dj140/FurutaPendulum_PJT/README.md

# FurutaPendulum_PJT

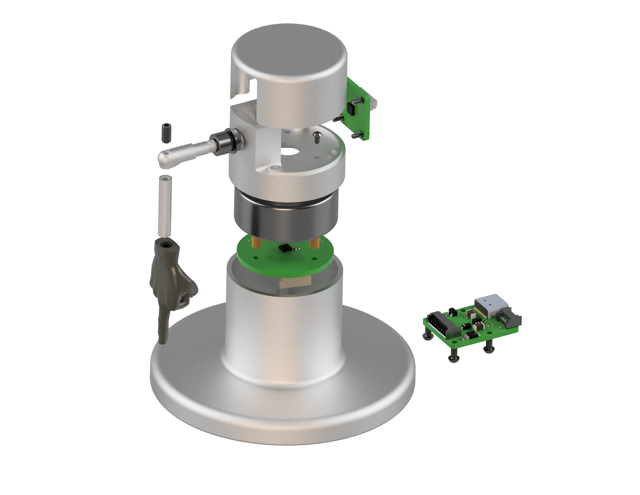
[picture p1: IMG/image2.png]


https://user-images.githubusercontent.com/33819388/154991899-b6fe6e4b-3fc9-4029-be56-d972ed57666c.mp4
