dj140/FurutaPendulum_PJT/IMG/image1.png

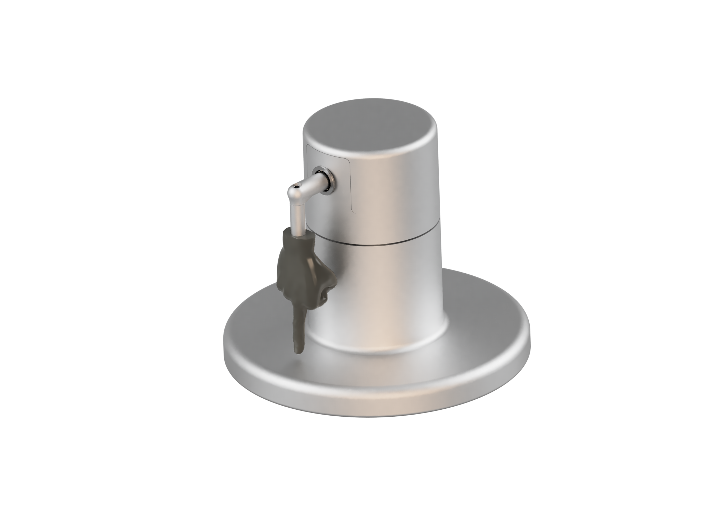
IMG/image1.png
