dj140/FurutaPendulum_PJT/IMG/image3.png

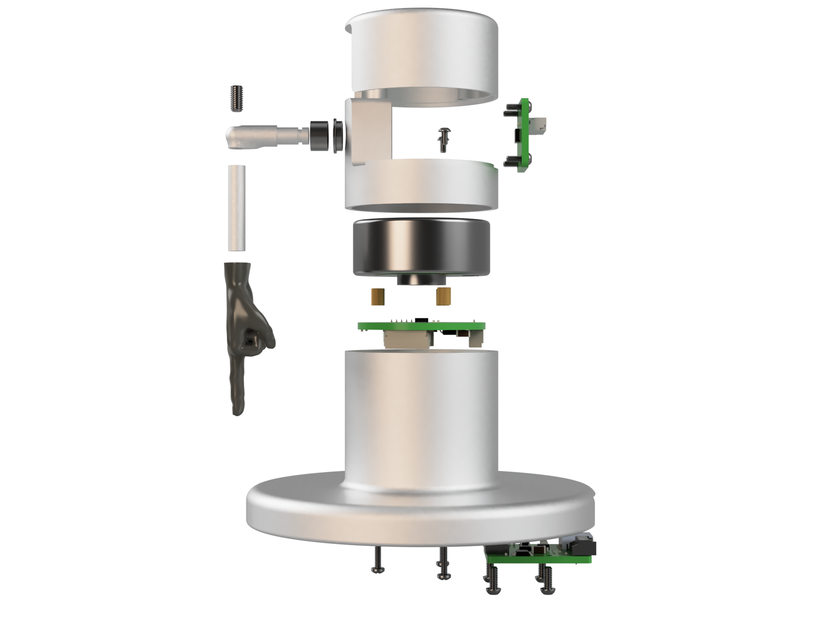
IMG/image3.png
