dj140/FurutaPendulum_PJT/Encoder_Board/bldc_motor_encoder.step

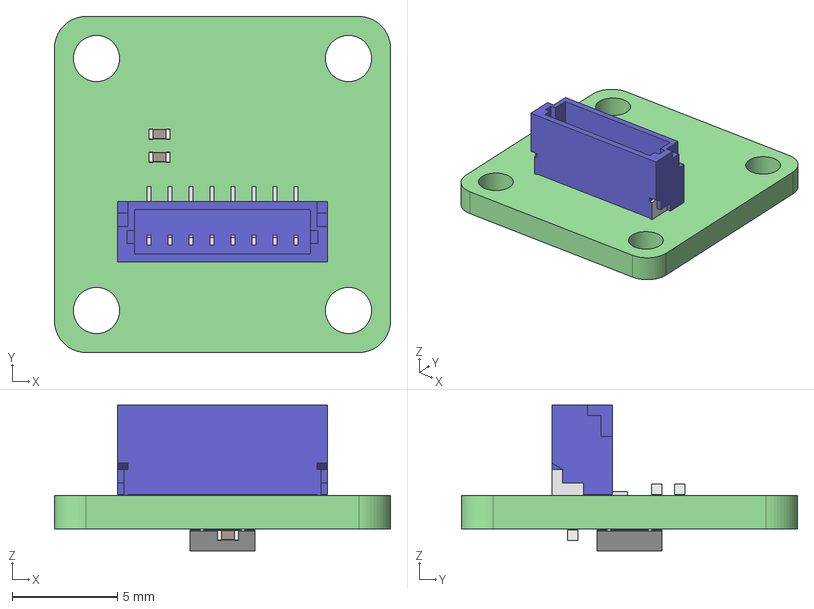
[picture p4: CAD file, 2022-02-07]
Encoder_Board/bldc_motor_encoder.step
16.0 x 16.0 x 6.93 mm
bldc_motor_encoder PCB
