dj140/FurutaPendulum_PJT/Motor_Board/STM32_FOC.kicad_pcb

## KiCad design Motor_Board/STM32_FOC.kicad_pcb (2022-02-07)

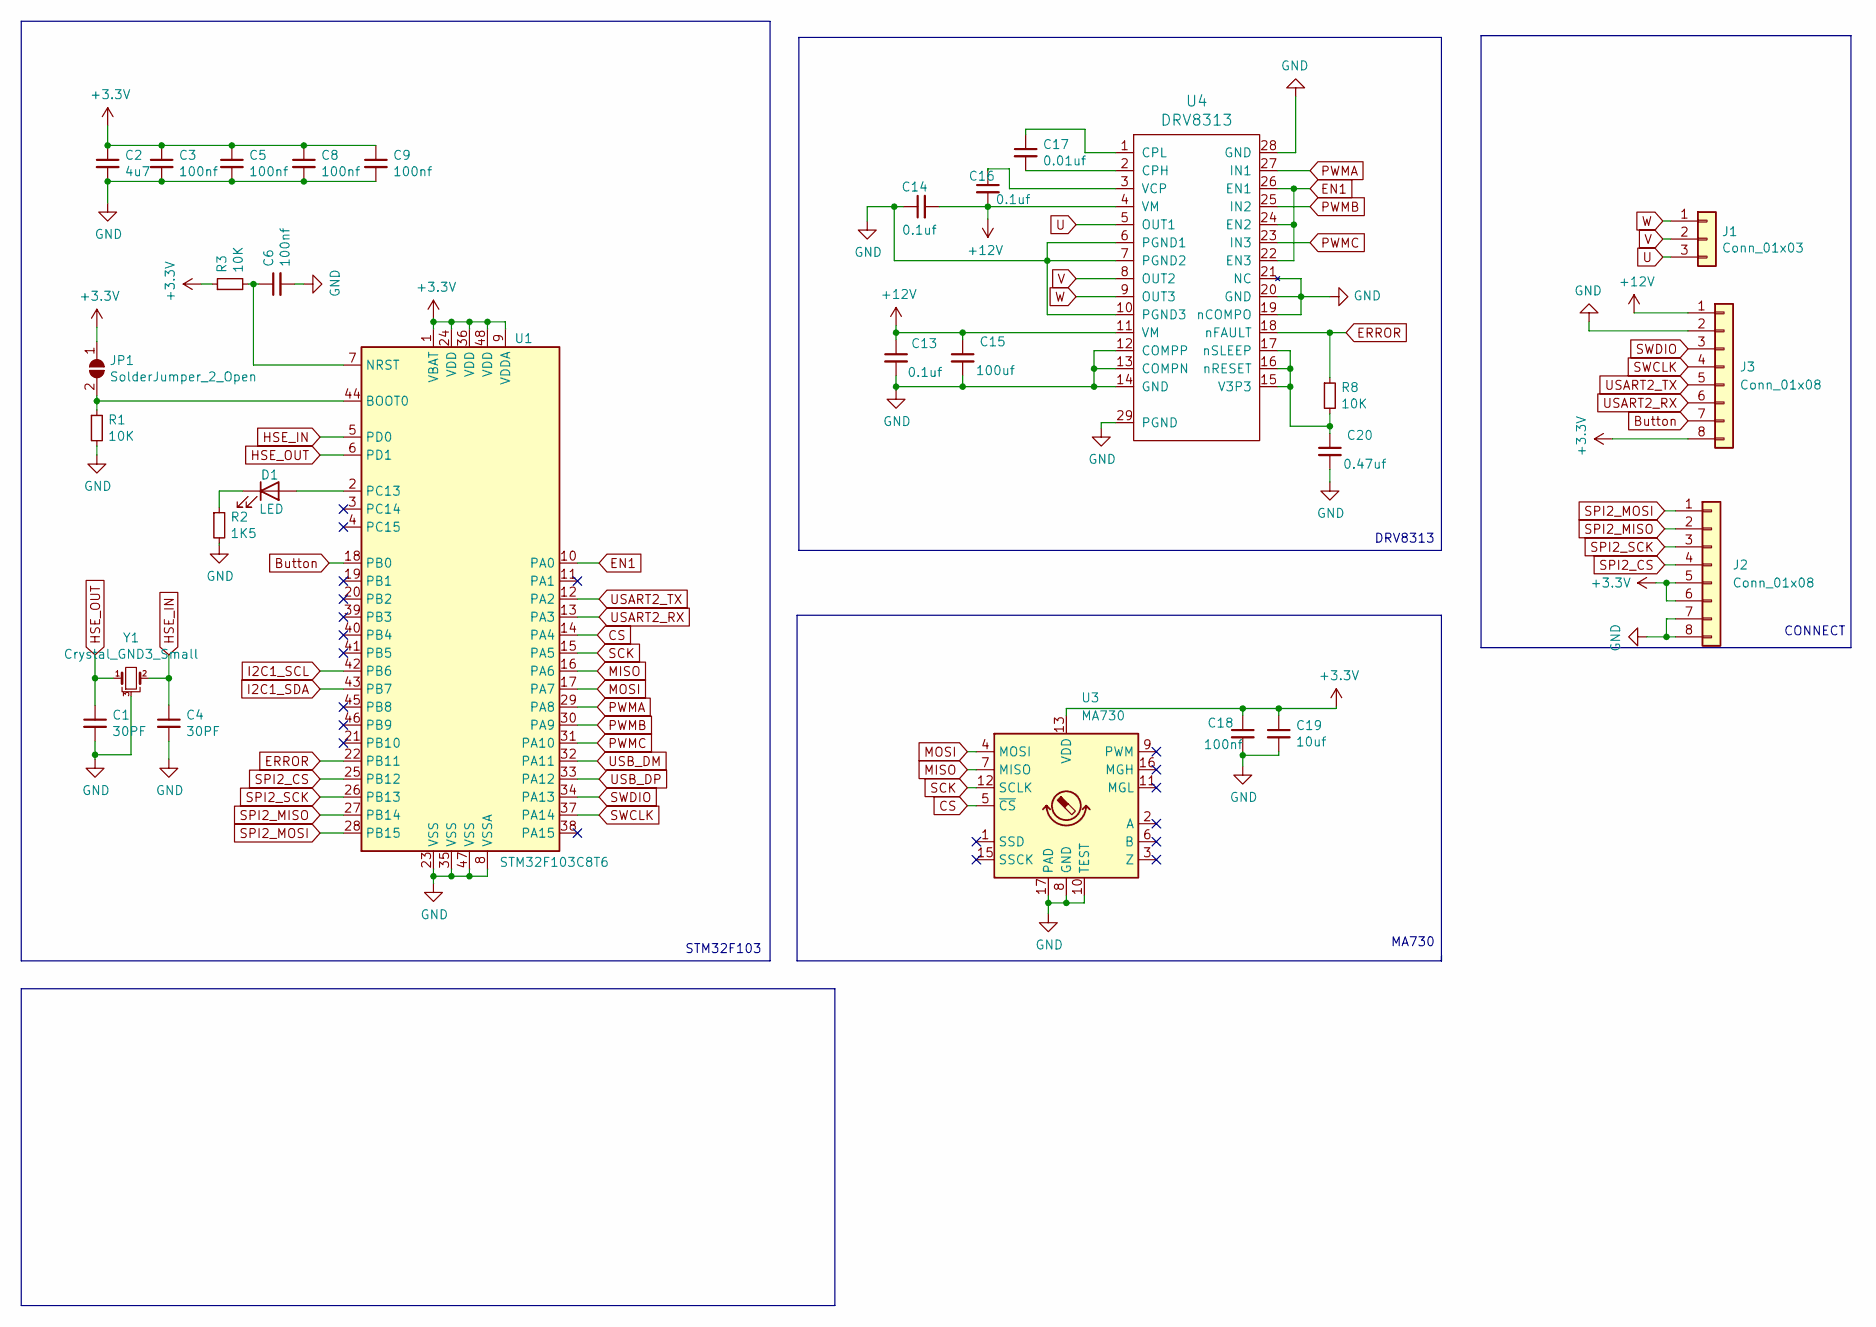
[picture p5: schematic STM32_FOC.kicad_sch]

Parts:
C1, C4: 30PF; C_0402_1005Metric
C2: 4u7; C_0402_1005Metric
C3, C5, C6, C8, C9, C18: 100nf; C_0402_1005Metric
C13: 0.1uf; C_0603_1608Metric
C14, C16: 0.1uf; C_0402_1005Metric
C15: 100uf; C_1206_3216Metric
C17: 0.01uf; C_0402_1005Metric
C19: 10uf; C_0402_1005Metric
C20: 0.47uf; C_0402_1005Metric
D1: LED; LED_0402_1005Metric
J1: Conn_01x03; Molex_PicoBlade_53047-0310_1x03_P1.25mm_Vertical
J2: Conn_01x08; JST_SH_BM08B-SRSS-TB_1x08-1MP_P1.00mm_Vertical
J3: Conn_01x08; Molex_PicoBlade_53047-0810_1x08_P1.25mm_Vertical
JP1: SolderJumper_2_Open; SoldJumper-2-P0.5mm_Open_RoundedPad
R1, R3, R8: 10K; R_0402_1005Metric
R2: 1K5; R_0402_1005Metric
U1: STM32F103C8T6; LQFP-48_7x7mm_P0.5mm
U3: MA730; QFN-16-1EP_3x3mm_P0.5mm_EP1.75x1.75mm
U4: DRV8313; IC_TPS61196PWPRQ1
Y1: Crystal_GND3_Small; CSTCE8M00G55-R0

Connections:
+3V3: C2.1, C3.1, C5.1, C8.1, C9.1, C18.1, C19.1, J2.5, J2.6, J3.8, JP1.1 (A), R3.1, U1.1 (VBAT), U1.9 (VDDA), U1.24 (VDD), U1.36 (VDD), U1.48 (VDD), U3.13 (VDD)
+12V: C13.1, C14.2, C15.1, C16.2, J3.1, U4.4 (VM), U4.11 (VM)
Button: J3.7, U1.18 (PB0)
CS: U1.14 (PA4), U3.5 (~CS)
EN1: U1.10 (PA0), U4.22 (EN3), U4.24 (EN2), U4.26 (EN1)
ERROR: R8.1, U1.22 (PB11), U4.18 (nFAULT)
GND: C1.2, C2.2, C3.2, C4.2, C5.2, C6.2, C8.2, C9.2, C13.2, C14.1, C15.2, C18.2, C19.2, C20.2, J2.7, J2.8, J3.2, R1.2, R2.2, U1.8 (VSSA), U1.23 (VSS), U1.35 (VSS), U1.47 (VSS), U3.8 (GND), U3.10 (TEST), U3.17 (PAD), U4.6 (PGND1), U4.7 (PGND2), U4.10 (PGND3), U4.12 (COMPP), U4.13 (COMPN), U4.14 (GND), U4.19 (nCOMPO), U4.20 (GND), U4.21 (NC), U4.28 (GND), U4.29 (PGND), U4.30, U4.31, U4.34, U4.41, U4.42, U4.43, U4.44, U4.45, U4.46, Y1.3
HSE_IN: C4.1, U1.5 (PD0), Y1.2
HSE_OUT: C1.1, U1.6 (PD1), Y1.1
I2C1_SCL: U1.42 (PB6)
I2C1_SDA: U1.43 (PB7)
MISO: U1.16 (PA6), U3.7 (MISO)
MOSI: U1.17 (PA7), U3.4 (MOSI)
unnamed: C6.1, R3.2, U1.7 (NRST)
unnamed: C16.1, U4.3 (VCP)
unnamed: C17.1, U4.1 (CPL)
unnamed: C17.2, U4.2 (CPH)
unnamed: C20.1, R8.2, U4.15 (V3P3), U4.16 (nRESET), U4.17 (nSLEEP)
unnamed: D1.1 (K), R2.1
unnamed: D1.2 (A), U1.2 (PC13)
unnamed: JP1.2 (B), R1.1, U1.44 (BOOT0)
PWMA: U1.29 (PA8), U4.27 (IN1)
PWMB: U1.30 (PA9), U4.25 (IN2)
PWMC: U1.31 (PA10), U4.23 (IN3)
SCK: U1.15 (PA5), U3.12 (SCLK)
SPI2_CS: J2.4, U1.25 (PB12)
SPI2_MISO: J2.2, U1.27 (PB14)
SPI2_MOSI: J2.1, U1.28 (PB15)
SPI2_SCK: J2.3, U1.26 (PB13)
SWCLK: J3.4, U1.37 (PA14)
SWDIO: J3.3, U1.34 (PA13)
U: J1.3, U4.5 (OUT1)
USART2_RX: J3.6, U1.13 (PA3)
USART2_TX: J3.5, U1.12 (PA2)
USB_DM: U1.32 (PA11)
USB_DP: U1.33 (PA12)
V: J1.2, U4.8 (OUT2)
W: J1.1, U4.9 (OUT3)

Notes on the sheet:
MA730
STM32F103
CONNECT
DRV8313

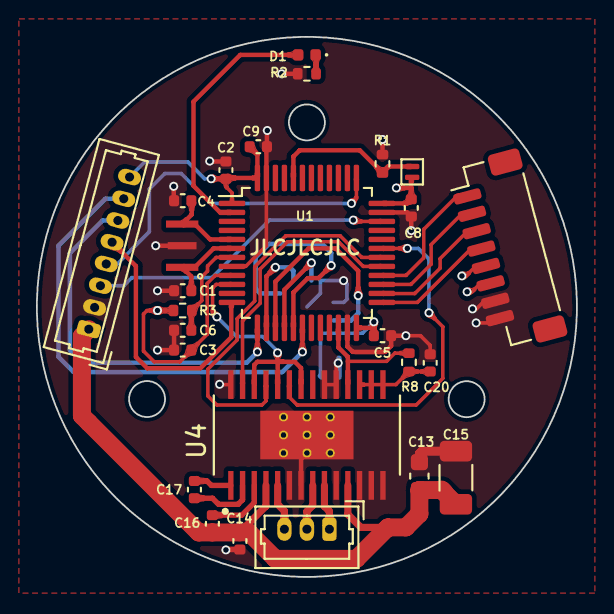
[picture p6: board STM32_FOC.kicad_pcb from above]

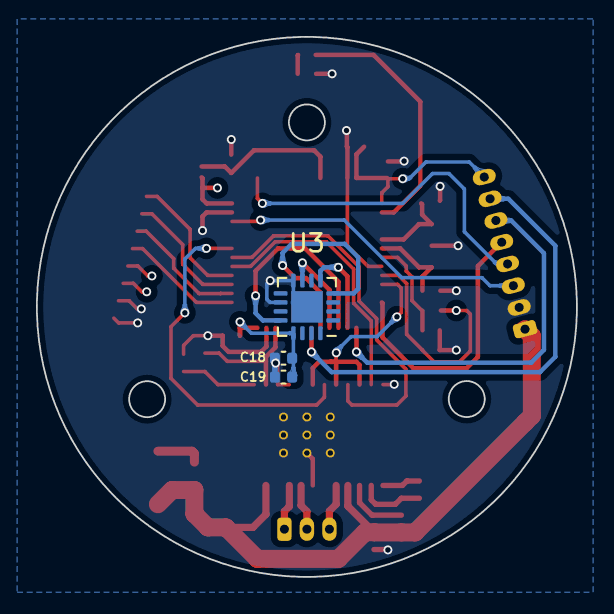
[picture p7: board STM32_FOC.kicad_pcb from below]

Board: 4 copper layers, 30.0 x 30.0 mm, 29 parts (3 on the bottom side), 34 nets.
