dj140/FurutaPendulum_PJT/Power_Board/FurutaPendulum_Power_Board.kicad_pcb

## KiCad design Power_Board/FurutaPendulum_Power_Board.kicad_pcb (2022-02-07)

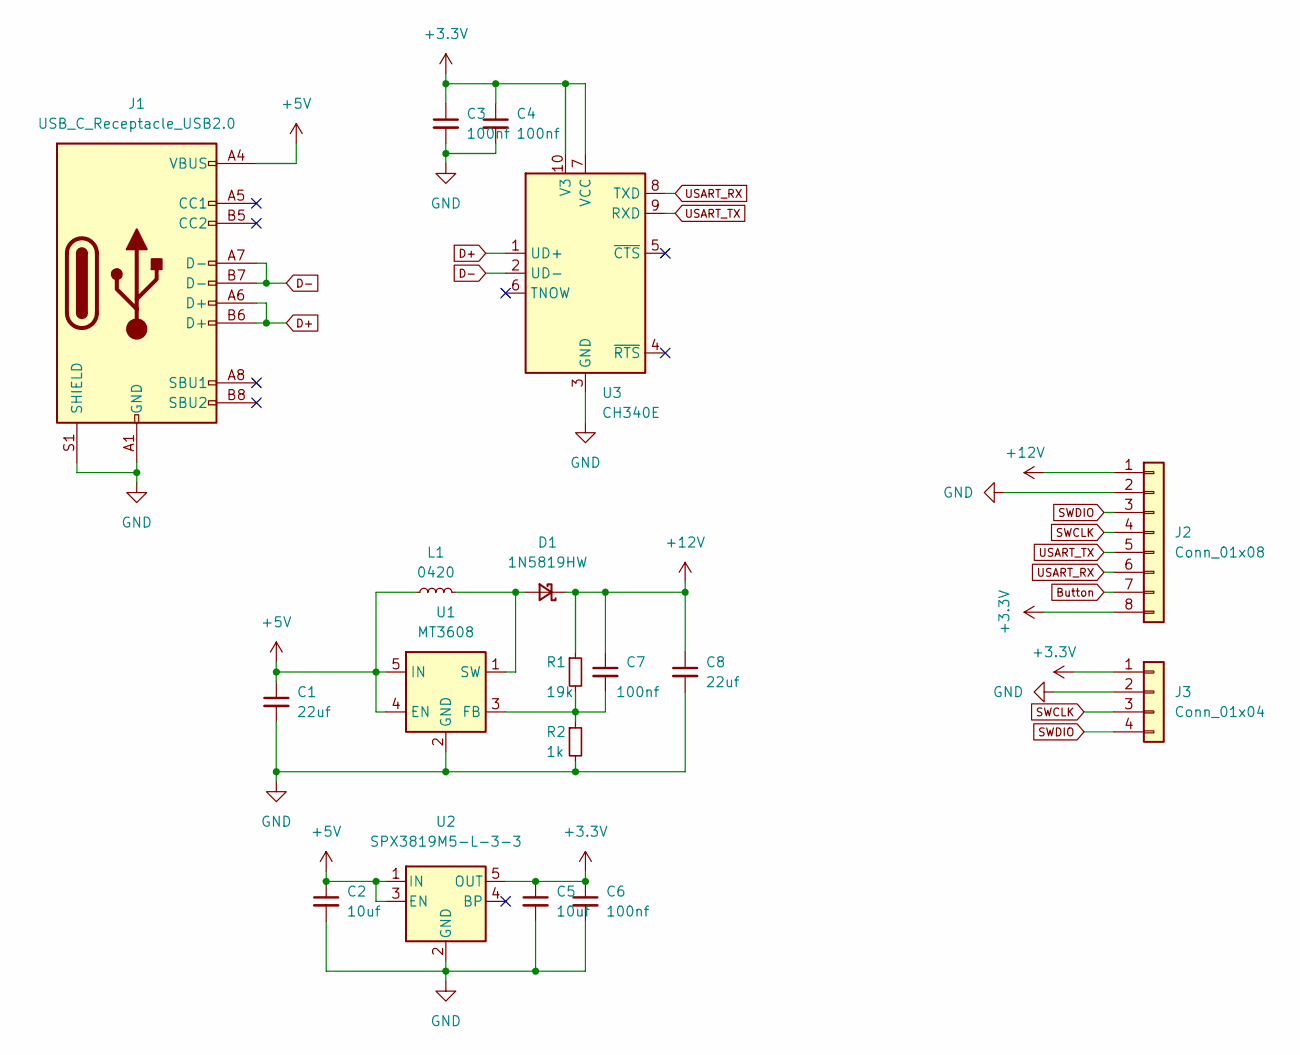
[picture p8: schematic FurutaPendulum_Power_Board.kicad_sch]

Parts:
C1, C8: 22uf; C_1206_3216Metric
C2, C5: 10uf; C_0402_1005Metric_Pad0.74x0.62mm_HandSolder
C3, C4, C6, C7: 100nf; C_0402_1005Metric_Pad0.74x0.62mm_HandSolder
D1: 1N5819HW; D_SOD-123
J1: USB_C_Receptacle_USB2.0; USB_C_Receptacle_HRO_TYPE-C-31-M-12
J2: Conn_01x08; Molex_PicoBlade_53048-0810_1x08_P1.25mm_Horizontal
J3: Conn_01x04; Molex_PicoBlade_53048-0410_1x04_P1.25mm_Horizontal
L1: 0420; L_0420
R1: 19k; R_0402_1005Metric_Pad0.72x0.64mm_HandSolder
R2: 1k; R_0402_1005Metric_Pad0.72x0.64mm_HandSolder
U1: MT3608; SOT-23-6
U2: SPX3819M5-L-3-3; SOT-23-5
U3: CH340E; MSOP-10_3x3mm_P0.5mm

Connections:
+3V3: C3.1, C4.1, C5.1, C6.1, J2.8, J3.1, U2.5 (OUT), U3.7 (VCC), U3.10 (V3)
+5V: C1.1, C2.1, J1.A4 (VBUS), J1.A9 (VBUS), J1.B4 (VBUS), J1.B9 (VBUS), L1.1, U1.4 (EN), U1.5 (IN), U2.1 (IN), U2.3 (EN)
+12V: C7.1, C8.1, D1.1 (K), J2.1, R1.1
Button: J2.7
D+: J1.A6 (D+), J1.B6 (D+), U3.1 (UD+)
D-: J1.A7 (D-), J1.B7 (D-), U3.2 (UD-)
GND: C1.2, C2.2, C3.2, C4.2, C5.2, C6.2, C8.2, J1.A1 (GND), J1.A12 (GND), J1.B1 (GND), J1.B12 (GND), J1.S1 (SHIELD), J2.2, J3.2, R2.2, U1.2 (GND), U2.2 (GND), U3.3 (GND)
unnamed: C7.2, R1.2, R2.1, U1.3 (FB)
unnamed: D1.2 (A), L1.2, U1.1 (SW)
SWCLK: J2.4, J3.3
SWDIO: J2.3, J3.4
USART_RX: J2.6, U3.8 (TXD)
USART_TX: J2.5, U3.9 (RXD)

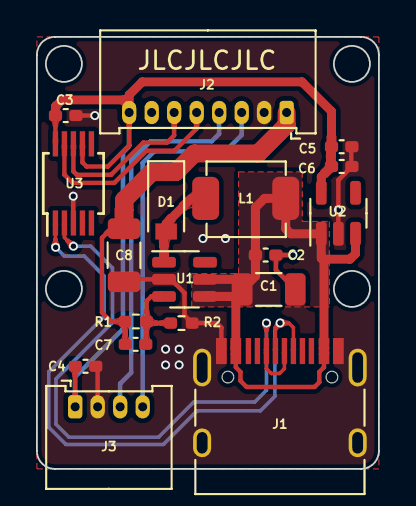
[picture p9: board FurutaPendulum_Power_Board.kicad_pcb from above]

Board: 4 copper layers, 19.0 x 24.0 mm, 18 parts (0 on the bottom side), 12 nets.
