dj140/FurutaPendulum_PJT/Encoder_Board/bldc_motor_encoder.kicad_pcb

## KiCad design Encoder_Board/bldc_motor_encoder.kicad_pcb (2022-02-07)

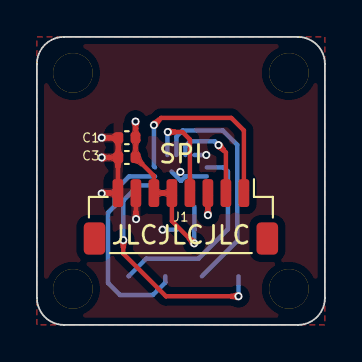
[picture p10: board bldc_motor_encoder.kicad_pcb from above]

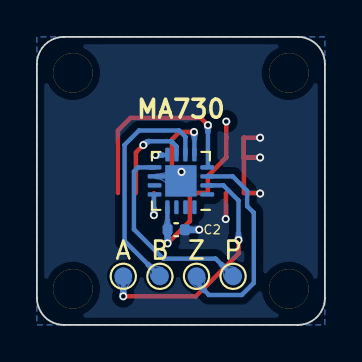
[picture p11: board bldc_motor_encoder.kicad_pcb from below]

Board: 4 copper layers, 16.0 x 16.0 mm, 13 parts (6 on the bottom side), 10 nets.

Parts:
A: TestPoint_Small; TestPoint_Pad_D1.0mm
B: TestPoint_Small; TestPoint_Pad_D1.0mm
C1: 1uF; C_0402_1005Metric
C2, C3: 100nF; C_0402_1005Metric
H1, H2, H3, H4: MountingHole; MountingHole_2.2mm_M2
J1: Conn_01x08; JST_SH_BM08B-SRSS-TB_1x08-1MP_P1.00mm_Vertical
P: TestPoint_Small; TestPoint_Pad_D1.0mm
U1: MA730; QFN-16-1EP_3x3mm_P0.5mm_EP1.75x1.75mm
Z: TestPoint_Small; TestPoint_Pad_D1.0mm

Connections:
+3V3: C1.1, C2.1, C3.1, J1.5, J1.6, U1.13 (VDD)
GND: C1.2, C2.2, C3.2, J1.7, J1.8, U1.8 (GND), U1.10 (TEST), U1.17 (PAD)
unnamed: A.1, U1.2 (A)
unnamed: B.1, U1.6 (B)
unnamed: J1.1, U1.4 (MOSI)
unnamed: J1.2, U1.7 (MISO)
unnamed: J1.3, U1.12 (SCLK)
unnamed: J1.4, U1.5 (~CS)
unnamed: P.1, U1.9 (PWM)
unnamed: U1.3 (Z), Z.1
